glensimister/rombi/README.md

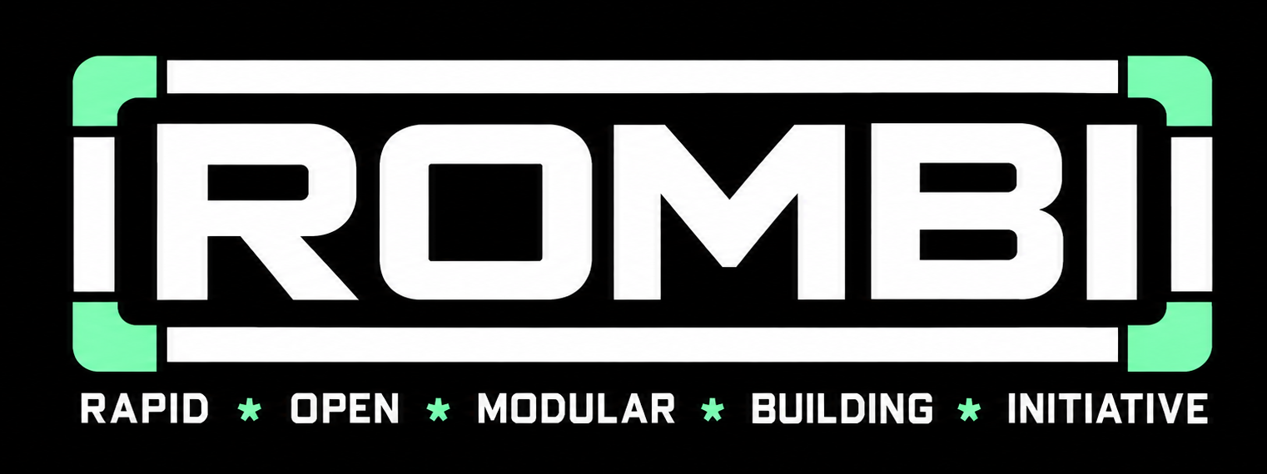
[picture p1: images/rombi_mint_wordmark.png]


<p>ROMBI consists of modular panels that can be made with practically no skills. There are some good modular framing systems out there, such as V-slot and T-slot, but they are typically meant for engineers. They are too heavy, too expensive, and relatively inaccessible to the average person. I came up with this system to make modular construction fast, affordable and accessible.</p>

<p>A lot of time and money has already gone into this project, and I plan to keep improving it. Please support me by making a donation:</p>
<a href="https://www.paypal.com/donate/?hosted_button_id=NUNFJG6USY3QL" target="_blank">
  
</a>

## Documentation

- [Assembly Guide](docs/assembly-guide.md)
- [Materials and Tools](docs/materials-and-tools.md)
- [Design Principles](docs/design-principles.md)
- [Use Cases](docs/use-cases.md)

Please also check out: - [Why ROMBI Could Be a Good Fit for Liberland](docs/rombi-and-liberland.md)  

## NOTE: Below are photos of the prototype. The core design has since changed, although still roughly the same. There maybe also be some inconsistencies, such as mismatching corner connectors, which will be addressed in due course. I will upload more photos as the project progresses.   

<center>
  <table>
      <tr>
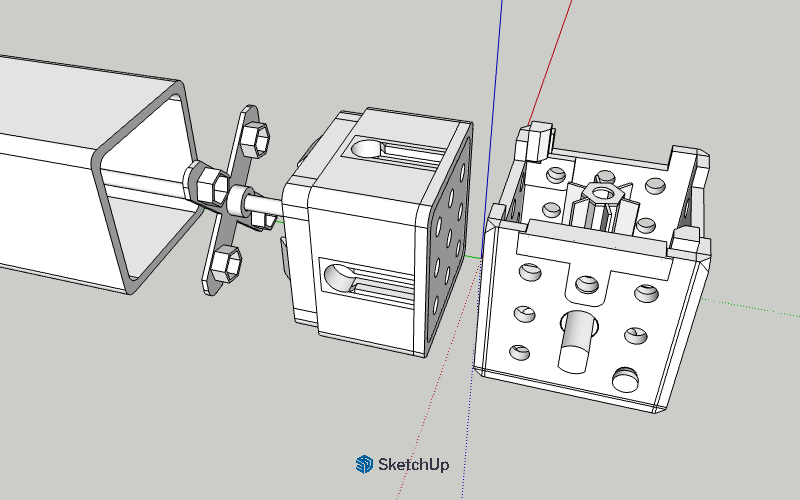
[picture p2: images/V1/3D-models-partially-constructed.png]
              <td></td>
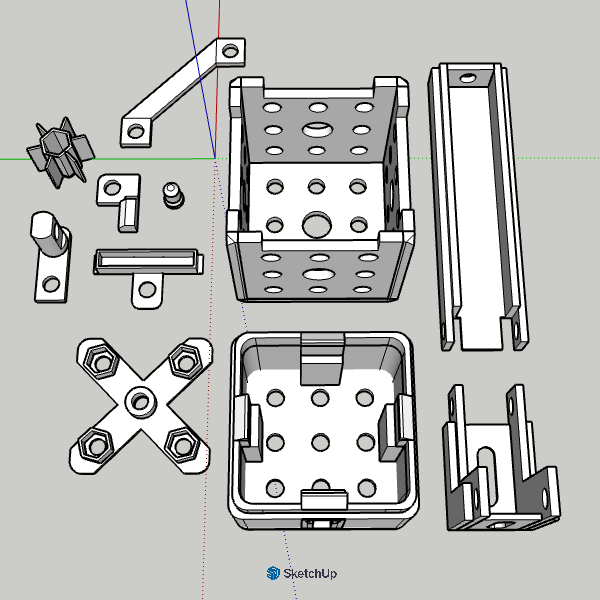
[picture p3: images/V1/3D-models-collection.png]
              <td></td>
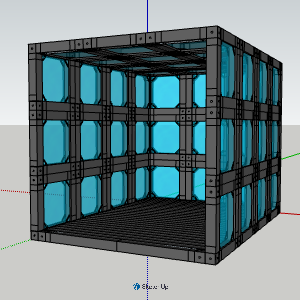
[picture p4: images/van-conversion-interia.png]
              <td></td>
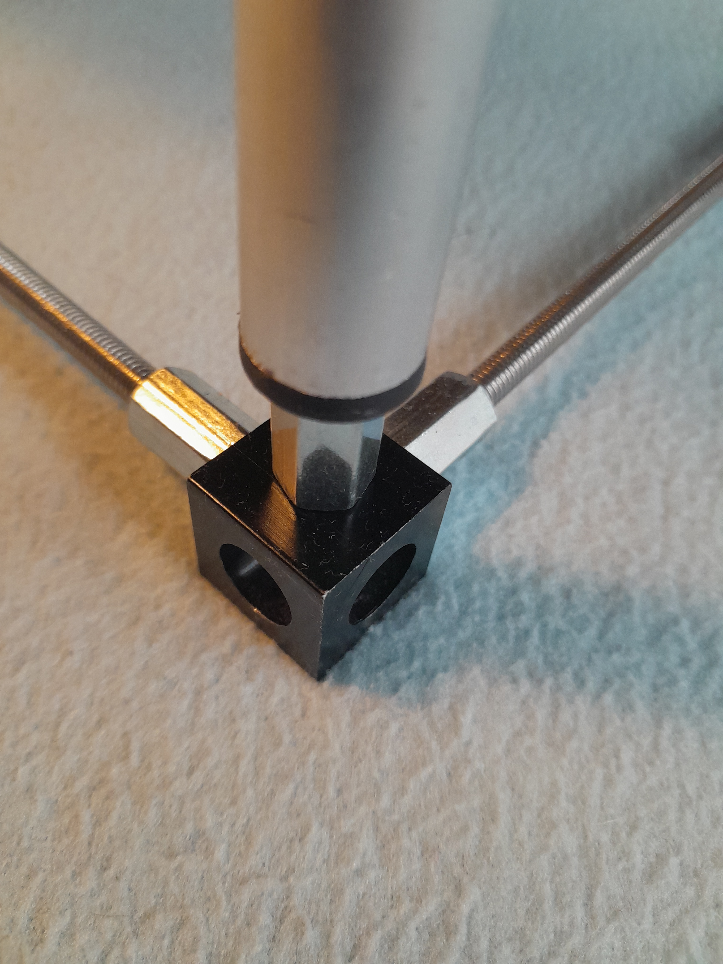
[picture p5: images/photos/20261106_133503.jpg]
              <td></td>
        </tr>
    <tr>
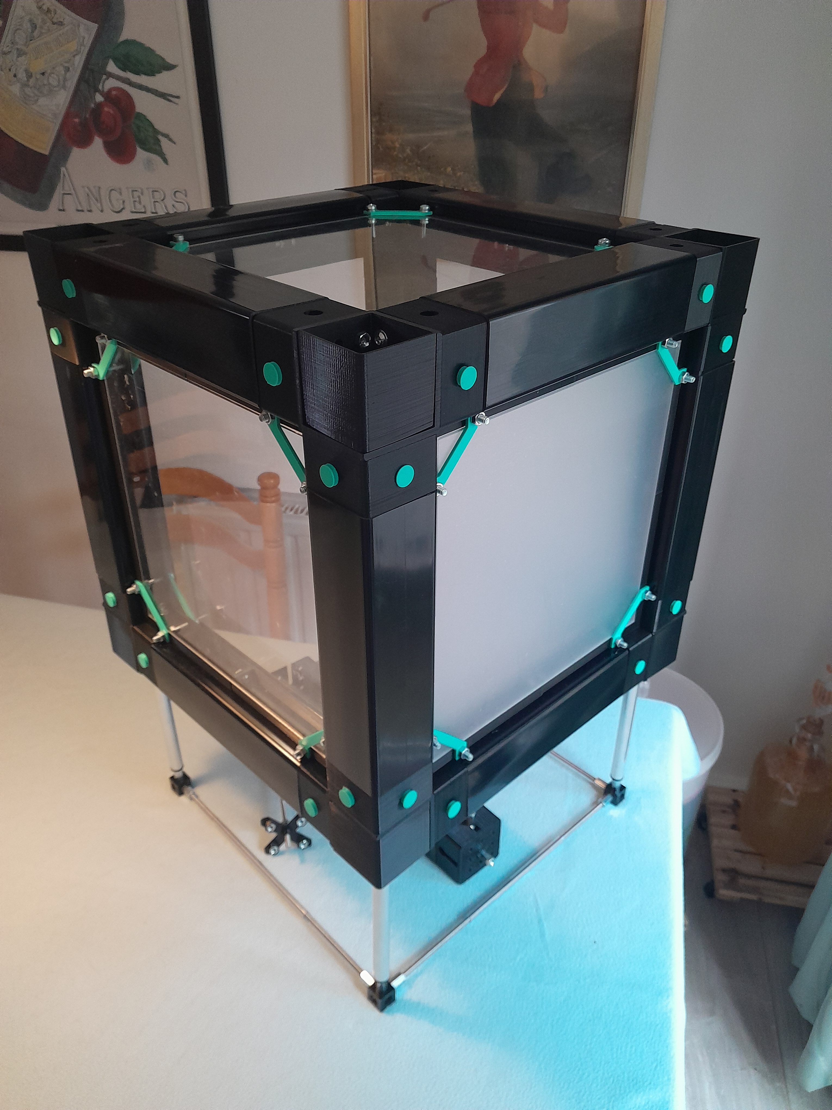
[picture p6: images/photos/20261106_133025.jpg]
      <td></td>
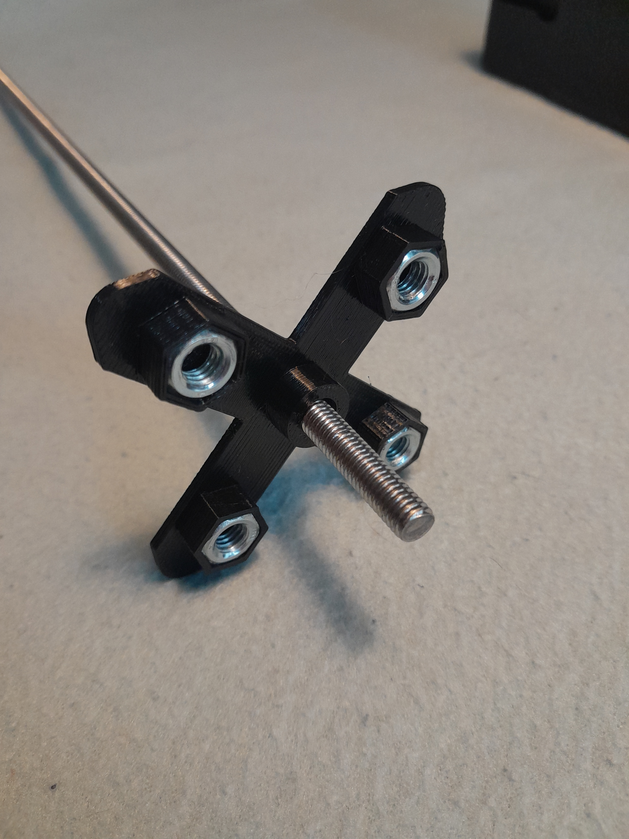
[picture p7: images/photos/20261106_133137.jpg]
      <td></td>
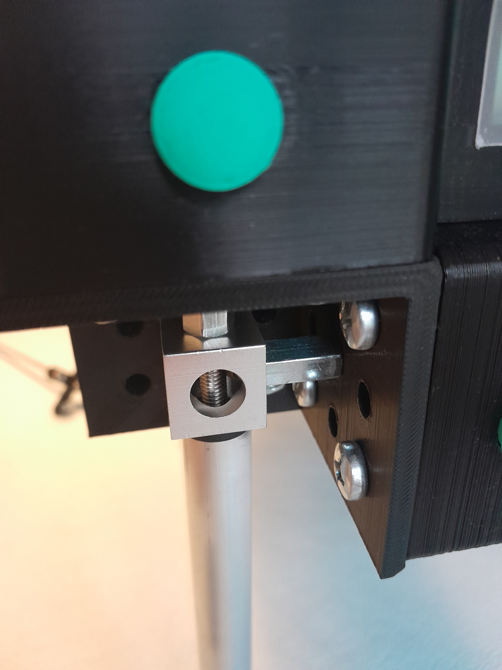
[picture p8: images/photos/20261106_134456.jpg]
      <td></td>
      <td></td>
    </tr>
        <tr>
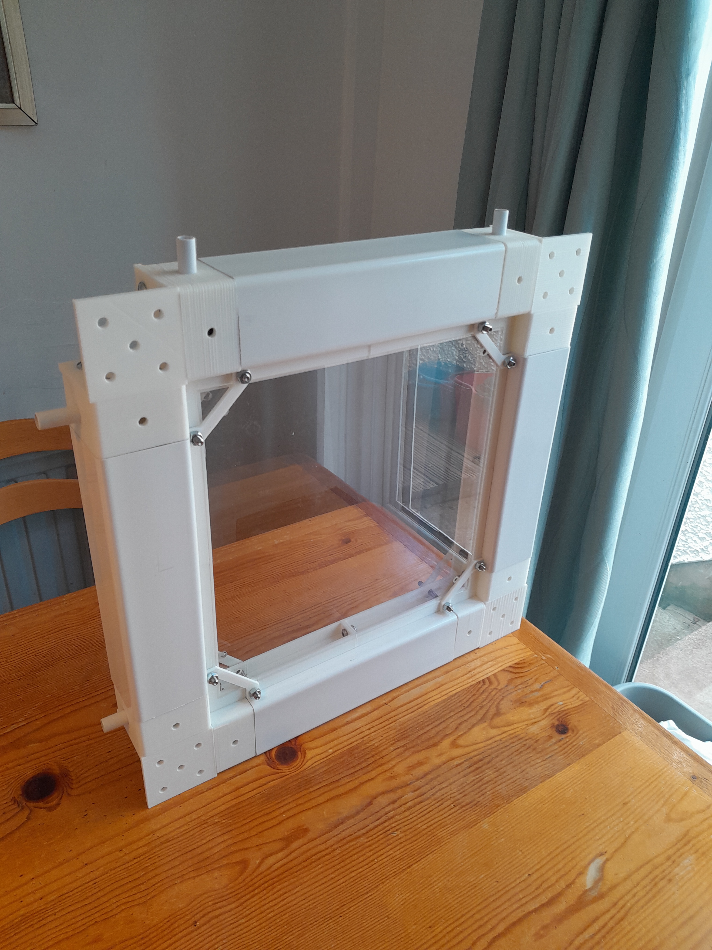
[picture p10: images/Single-panel-white.jpg]
              <td></td>
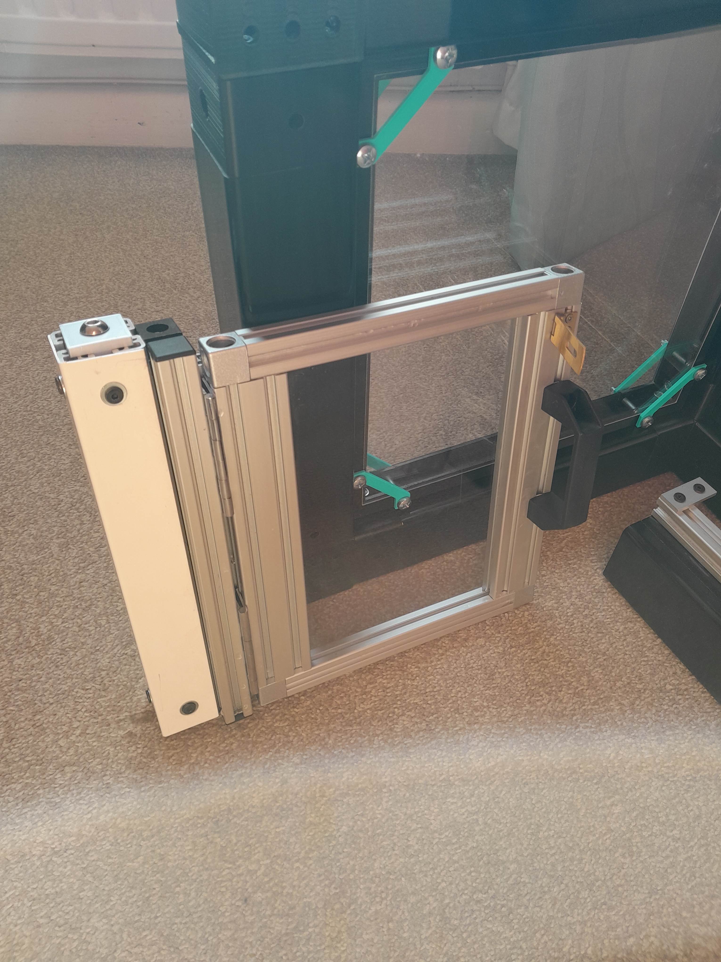
[picture p11: images/V-Slot-Door.jpg]
              <td></td>
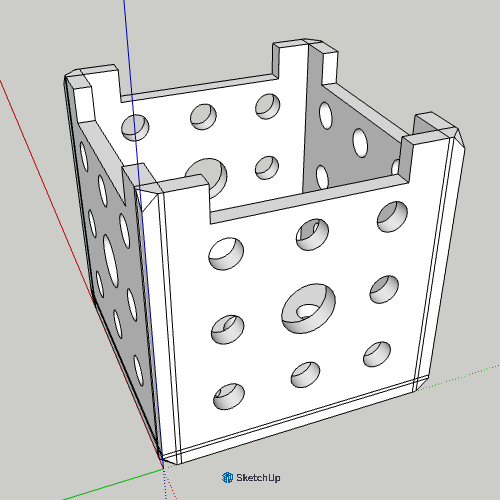
[picture p12: images/V1/5-way-connector-with-spanner-slot-V1.png]
              <td></td>
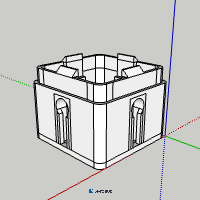
[picture p13: images/V1/keyhole-spindle-V1.png]
              <td></td>
        </tr>
  </table>
</center>

<p>ROMBI is made from a combination of standard British FloPlast square drain pipe, 3D printed corner connectors, and off-the-shelf perspex sheets. As such, it is very affordable. The square pipe is currently available in black, white and brown, while the 3D printed connectors can be any colour. </p>
<p>Different countries have different standards. The repository can be cloned and adapted accordingly. However, I don't plan to cater for different standards quite yet.</p>  

 <p>ROMBI can be used for Room Partitions, Sensory Deprivation Enclosures, Cinema, Gaming & VR Booths, Children's Mini-Cinemas & Hideaways, Personal Focus & Video-Call Booths, Vocal, Voiceover & Podcast Booths, Mobile DJ & Karaoke Booths, Photo & Content-Creation Booths, Pet Shelters & Animal Enclosures, Livestock & Veterinary Recovery Enclosures, Kiosks & Exhibition Booths, 3D Printer & Equipment Enclosures, Generator Enclosures Server & Network Enclosures, Food Fermentation & Proofing Chambers, Hydroponic & Growing Chambers, Battery Energy Storage, Enclosures Emergency & Earthquake Shelters, and more. </p>

<p>ROMBI is currently version 1, marked as V1. It will stay on V1 until a core change has been made (affecting the majority of components). At which point a new folder will be created (V2), with V1 kept as legacy. Ideally, there won't be many (if any) changes to the core.</p>
<p>The size of a single panel is 455mm x 455mm x 65mm. All sizes are multiples of 65mm, the size of the PVC square pipe. E.g. 65 x 7 = 455. This allows you to use the square pipe for floor and roof panels.</p>

<h2>Windows & Doors</h2><p>The design doesn’t include openable windows and doors yet. I plan to use V-slot (see the adjecent image) for the doors due to the advanced sliding/railing systems. I want the doors to be more futuristic/advanced, as opposed to the typical style.</p>
