glensimister/rombi/docs/design-principles.md

[← Back to ROMBI home](../README.md)

## Principles of Modular Design, and how ROMBI Addresses Them
<p>
Before discussing the principles of modular design, and how ROMBI Addresses them, let's start by reviewing the limitations of modular building systems.

Security: Naturally, the more secure a structure is, the less modular it will be. If it’s easy to build and maintain, it will be easy to steal and sabotage. However, that doesn’t mean it is impossible to apply security techniques to prevent unauthorized access, it just means it should be an after-thought. For example, the window panels are very easy to replace. However, to get around this, you could use one-way bolts, with the nut on the inside of the structure. Even still, this shouldn’t be a part of the ROMBI core. After all, you might live in a gated community, or decide to put the structure inside another, more secure structure. I (and hopefully others) will provide security add-ons, and you can choose which is the most suitable.  

Waterproofing: The use of sealant would make the structure less modular. It might be tempting, but it should be used as a last resort. As above, add-ons will be available, but waterproofing will not be a part of the ROMBI core. Perhaps you might want to consider putting the structure inside a large greenhouse or geodesic dome. Some do this in Scandinavia, and there are many benefits of doing so. Alternatively, you might want to put it under a gazebo, or inside a warehouse, shipping container or van.  

Open-Plan: Open-plan spaces typically require large support beams. However, it’s worth bearing in mind that the maximum length of square downpipe in the UK is 5.5 meters. As such you can build an open-plan space that size. The pipe won’t provide much structural strength, but it’s fine for a single-story structure with an outer shell. 

Windows & Doors: Since we don’t know what we are building, it’s quite hard to design a universal system for windows and doors. I suggest using v-slot for this purpose. I have already built a small test door using v-slot, and I will upload the specs at a later stage.  
</p>

| Principle | Description | How ROMBI addresses it |
|---|---|---|
| **Accessibility** | Materials and components should be inexpensive and readily available. | ROMBI uses standard PVC square downpipe, M6 threaded rods, off-the-shelf Perspex sheets and 3D-printed connectors. Users are encouraged to substitute locally available materials to suit their region. |
| **Flexibility and Reusability** | Components should be reusable and adaptable to different applications without requiring a complete rebuild. | The modular connectors and panels allow structures to be assembled, disassembled, reconfigured and repurposed. |
| **Precision and Consistency** | Components should have consistent dimensions and interfaces, allowing them to fit together reliably. | ROMBI uses defined component dimensions and standardised connection points. Future revisions will aim to improve tolerances and interchangeability. |
| **Lightweight Construction** | Components should be lightweight enough to handle and assemble without heavy equipment. | The system uses lightweight PVC framing, thin sheet materials and 3D-printed connectors, reinforced with threaded steel rods where required. |
| **Simple Assembly and Maintenance** | Structures should be quick to assemble, disassemble and maintain, ideally without power tools. | The system is designed around modular connections and commonly available hardware, minimising the need for specialist tools or permanent fixings. |
| **Structural Integrity** | Connections and structural members should work together to provide adequate strength and stability for their intended application. | ROMBI incorporates steel threaded rods and aluminium V-slot corner cubes into its reinforced frame design. Structural performance must be validated for each intended application. |
| **Version Control** | Design changes should be documented so that components and assemblies can be identified, reproduced and improved. | ROMBI uses numbered design series, beginning with Series 1. Design files and documentation are maintained in a version-controlled repository. |
| **Flat-Packability and Portability** | Components should be easy to transport and store, with minimal wasted space. | The system can be disassembled into individual components and flat-packed. In principle, a building can be dismantled, transported and reassembled at a new location. |
| **Environmental Responsibility** | Materials and construction methods should minimise waste and environmental impact throughout the product lifecycle. | Reusability, lightweight transportation, repairability and the avoidance of concrete and timber in the primary frame are design considerations. Material durability, recyclability and whole-life impacts remain important considerations. |
| **Customisation** | Users should be able to adapt the appearance and configuration to their own preferences. | Frame colours can be selected to suit available materials, while 3D-printed connectors and accessories can be produced in different colours. Panels, dimensions and layouts can be adapted to individual projects. |
| **Cross-Compatibility** | A modular system should integrate with established products, components and standards wherever practical. | ROMBI is intended to accommodate compatible third-party systems, including V-slot aluminium extrusion for doors, openable windows and other accessories. |
| **Integrated Cable Management** | Electrical cables and other services should be accommodated without unnecessarily obstructing the structure or requiring extensive modifications. | Holes in the corner connectors allow cables to pass internally or externally. Unused openings can be closed with removable plugs. |
| **Scalability** | The same underlying principles should apply to projects of different sizes, from small enclosures to larger structures. | ROMBI is being developed as a common modular platform for a range of applications, with the long-term aim of scaling from small prototypes towards larger buildings. |
| **Repairability and Replaceability** | Individual parts should be replaceable without requiring the entire structure to be dismantled or discarded. | Modular construction allows damaged or outdated components to be replaced individually, subject to accessibility of the relevant connections. |
| **Open Design and Collaboration** | Design files and documentation should be available so that others can inspect, reproduce, modify and improve the system. | ROMBI is intended to be an openly documented project. Users are encouraged to fork the repository, adapt the designs to locally available materials and contribute improvements. |
| **Documentation and Reproducibility** | A design should be documented well enough for others to understand, reproduce and maintain it without relying on the original designer. | The project will include CAD and manufacturing files, assembly instructions, material specifications, photographs and records of design revisions. |
| **Adaptability to Local Materials** | A modular system should not depend on the availability of one particular material or product in every country. | Although the initial design uses UK-standard 65 mm square downpipe, the open design allows users to develop alternative connectors and structural dimensions for materials available in their own regions. |
| **Minimal Specialist Equipment** | Construction should be achievable by individuals and small groups without access to industrial machinery. | The system relies on accessible materials, 3D-printed components and common hardware, with the aim of keeping fabrication and assembly requirements manageable. |
| **Incremental Development** | A system should be useful at small scales before requiring users to commit to a large or expensive project. | ROMBI can be developed and tested through small applications before being extended to more complex assemblies and larger structures. |
| **Long-Term Adaptability** | Structures should be capable of evolving as requirements change, rather than becoming obsolete when a single component or use case changes. | Replaceable modules, standardised interfaces and documented revisions are intended to allow existing structures to be modified as new components and applications are developed. |
