glensimister/rombi/images/V1/hex-nut-holder-V1.png

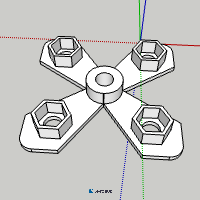
images/V1/hex-nut-holder-V1.png
