glensimister/rombi/docs/components.md

[← Back to ROMBI home](../README.md)

# Components & Files

Below are the STL files for the main panel. Please note that I made them using Sketchup Online, and was thus only able to export as STL format. At some point I will try to provide other formats.  

| Image | Description | Link to file | Version
|:---:|---|:---:|:---:|
|  | **5-Way Corner Connector** | [STL](../STL/V1/5-way-connector-with-spanner-slot-V1.stl) | 1 | 
|  | **Keyslot Spindle** | [STL](../STL/V1/keyslot-spindle-V1.stl)  | 1 | 
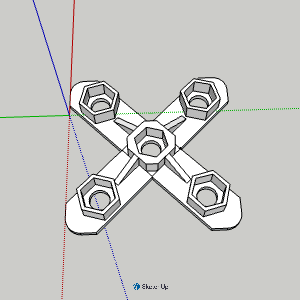
[picture p20: images/V1/strut-fastener-V1.png]
|  | **Strut Fastener** | [STL](../STL/V1/strut-fastener-V1.stl)  | 1 | 
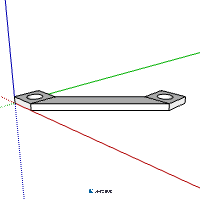
[picture p21: images/V1/panel-clip-V1.png]
|  | **Panel Clip** | [STL](../STL/V1/panel-clip-V1.stl)  | 1 | 
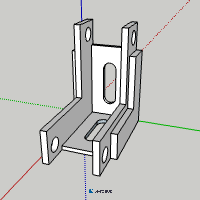
[picture p22: images/V1/panel-holder-corner-slotted.png]
|  | **Panel Holder Corner** | [STL](../STL/V1/panel-holder-corner-slotted-V1.stl)  | 1 | 
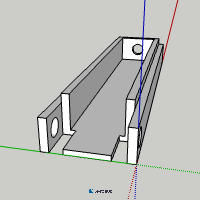
[picture p23: images/V1/panel-holder-long.png]
|  | **Panel Holder Long** | [STL](../STL/V1/panel-holder-long-V1.stl)  | 1 |
