glensimister/rombi/docs/materials-and-tools.md

[← Back to ROMBI home](../README.md)

## Equipment, Materials and Indicative Cost per L Panel

Modular construction systems can involve a higher initial material cost than conventional building methods because they require standardised components, specialised connectors and carefully designed interfaces. However, these upfront costs can potentially be offset by faster assembly, reduced labour, easier maintenance, and the ability to dismantle, reuse and reconfigure components.

As ROMBI develops, costs should decrease through design improvements, bulk purchasing, alternative suppliers and more efficient manufacturing methods. For further information, see **[Principles of Modular Design and How ROMBI Addresses Them](../docs/design-principles.md)**.

The following figures are **rough estimates based on current prototype materials and example retail prices**, not a fixed bill of materials or a final quotation. Actual costs will vary according to supplier, location, availability, quantity purchased, manufacturing method and future design revisions.

Readers are encouraged to source materials locally, manufacture components themselves where practical, or use third-party services. Optional equipment and accessories are listed separately and are excluded from the core estimate.

### 1. Equipment (Optional)

You do not need to own all the equipment listed below. For example, 3D-printed components can be ordered from a commercial printing service using the published design files.

| Equipment | Approximate Cost | Notes |
|---|---:|---|
| Creality Ender 3 KE 3D printer | £200 | Example printer. Any suitable printer or third-party printing service may be used. |
| PETG filament and filament dryer | Varies | Approximately 1 kg of PETG filament is required for the current L-panel design. Filament costs approximately £12 per kg. A dryer may be useful depending on storage conditions and print quality requirements. |
| Stanley clamping mitre box and saw | £60 | For cutting PVC pipe and other components to length. |
| 6 mm T-handle Allen key or equivalent | £5 | Some connectors require a tool with approximately 65 mm of reach. A suitable Allen key or hex driver may be sufficient. |

*Equipment costs are illustrative purchase prices, not mandatory expenses. The 3D printer is optional if parts are outsourced, and tools may already be available to the builder.*

### 2. Core Materials and Components

The following table describes the main materials used in the current L-panel prototype. Prices are approximate and may change as the design evolves.

| Image | Material / Component | Specification and Use | Approximate Cost |
|:---:|---|---|---:|
|  | **PVC square downpipe** | FloPlast 65 × 65 mm square downpipe, approximately 1.95 mm wall thickness, cut into 245 mm sections. Six sections are required per L panel. Example product standard: BS EN 12200-1:2004. Available in white, brown and black. | £3.70/m; approximately £5.50 per panel |
|  | **Clear acrylic sheets** | Four 300 × 300 mm sheets, 3 mm thick, form the double-glazed panels. The example price reflects a discounted purchase and is not a guaranteed retail price. | Approximately £12 for four sheets |
|  | **PETG filament** | Approximately 1 kg for the 3D-printed components in the current L-panel design. | Approximately £12 |
|  | **M6 × 16 mm button-head screws with flange** | ISO 7380-2:2011. Used to connect corner connectors to the spindles. Forty screws are required. | £6 per 20; approximately £12 for 40 (to be amended) |
|  | **M6 × 20 mm round coupling nuts** | Used between the panel-holder brackets. Sixteen are required. | Approximately £7 per 20; £5.60 for 16 |
|  | **M6 350mm threaded rods** | Fully threaded rods, approximately 350 mm long, used to reinforce the frame. Cutting rods to length from bulk stock may be cheaper but could require additional tools. | Approximately £17 per four-piece kit |
|  | **20 × 20 mm aluminium V-slot corner cubes** | Structural corner connectors used with the steel reinforcement rods. Six are required per L panel. | Approximately £15 per pack of 8; £11.25 allocated to six |
|  | **M6 hex stud connectors** | Approximately 18 mm long. Used as part of the connector assembly. Available from general hardware retailers. | Approximately £8 per pack of 30 ||
|  | **Standard M6 hex nuts** | DIN 934 / ISO 4032; 10 mm width across flats and approximately 5 mm high. Used where required by the threaded connections. | Approximately £5 per pack of 50 |

*Costs are indicative estimates. Pack prices, actual quantities used, supplier discounts and future design changes will affect the final cost.*

### 4. Optional Extras

These components are not required for every application and are excluded from the core material estimate.

| Optional Component | Description | Approximate Cost |
|---|---|---:|
| **PVC spacer tubes** | White PVC tube, approximately 12 mm outside diameter and 10 mm inside diameter, cut into 40 mm sections. Used for positioning panels and creating the stacking arrangement. Longer sections may also be used where needed. | £3.50 per metre |
| **M6 female-threaded gas spring strut end fittings** | Flexible threaded fittings that may provide additional reinforcement or alternative connection arrangements. Their suitability depends on the final structural design. | Approximately £10 per pack of 6 |
| **M6 serrated flanged nuts** | Used on panel-corner connectors where resistance to loosening is desirable. Sixteen are required in the current arrangement. | Approximately £2.95 per pack of 10 |
| **Foam pipe insulation** | Approximately 1.8 m of foam insulation, with an internal diameter of 43 mm and external diameter of 61 mm. Intended for placement inside the square PVC frame to improve insulation. | Approximately £12 |

### 5. Preliminary Cost Estimate

### IMPORTANT: The calculations below are based on the highest estimates. Naturally, buying in bulk (or ordering from China) will bring the costs down. This may not be an option at first, but could be an option at a later stage. For example, the v-slot corner cubes are much cheaper when buying from China. Additionally, the threaded rod is quite expensive when buying pre-cut sections. Cutting the rod yourself will bring the cost down a lot, but cutting metal is beyond the scope of this project.  

Based on the current design, the following is a provisional guide rather than a definitive price.

| Cost Category | Approximate Cost (rounded) |
|---|---:|
| PVC downpipe | £5 |
| Acrylic sheets | £12.00 |
| PETG filament | £12.00 |
| M6 × 16 mm button-head screws | £20 |
| M6 coupling nuts | £6 |
| Four-piece threaded-rod kit | £12.00 |
| Six aluminium V-slot corner cubes | £11 |
| **Subtotal of priced core items** | **£80** |

This subtotal includes the estimated cost of the specified quantities of priced components, including the PETG filament, but excludes the additional hardware whose quantities or costs have not been fully established. It also excludes optional extras, equipment, labour, outsourced 3D printing, delivery charges and any waste or spare materials.

The actual amount spent purchasing materials may be higher because some components are sold only in packs. Conversely, bulk purchasing, alternative suppliers, discounted materials and in-house manufacturing may reduce the effective cost.

**This is an early-stage estimate for the current prototype, not a final production cost.** A more accurate figure will be published when the design, bill of materials and manufacturing process are sufficiently stable.
