glensimister/rombi/STL/V1/strut-fastener-V1.stl

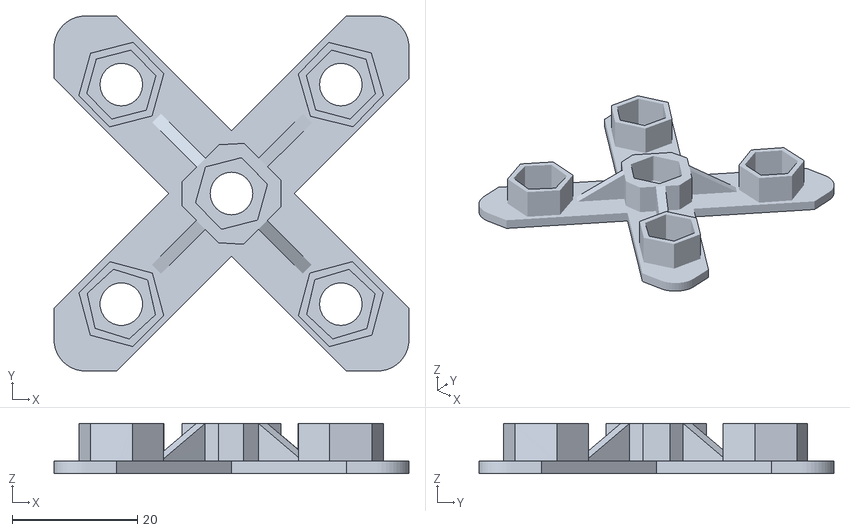
[picture p24: CAD file, 2026-11-12]
STL/V1/strut-fastener-V1.stl
56.6 x 56.6 x 8.00
