glensimister/rombi/STL/V1/16.5mm-measuring-tool-V1.stl

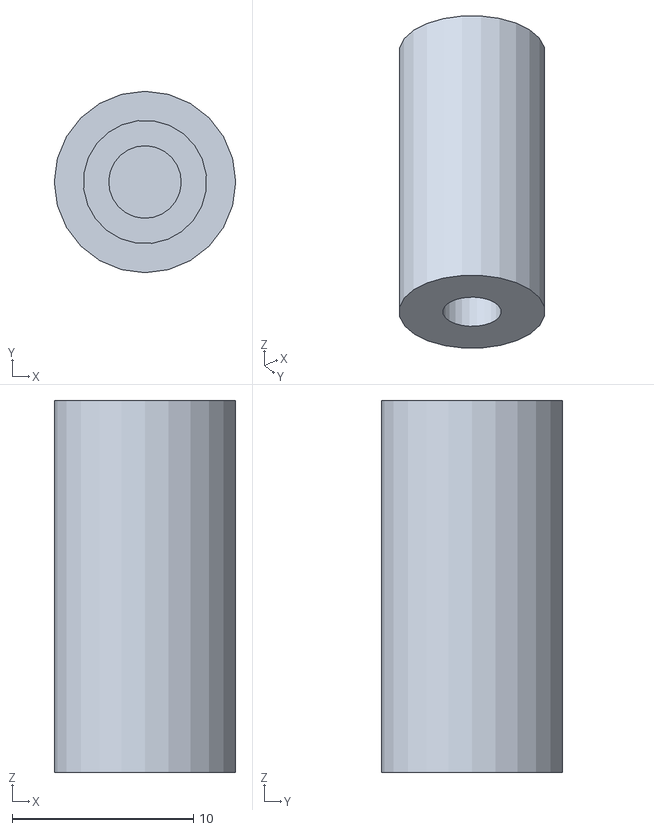
[picture p25: CAD file, 2026-11-12]
STL/V1/16.5mm-measuring-tool-V1.stl
10.0 x 10.0 x 20.5
