glensimister/rombi/STL/V1/spanner-slot-cover-V1.stl

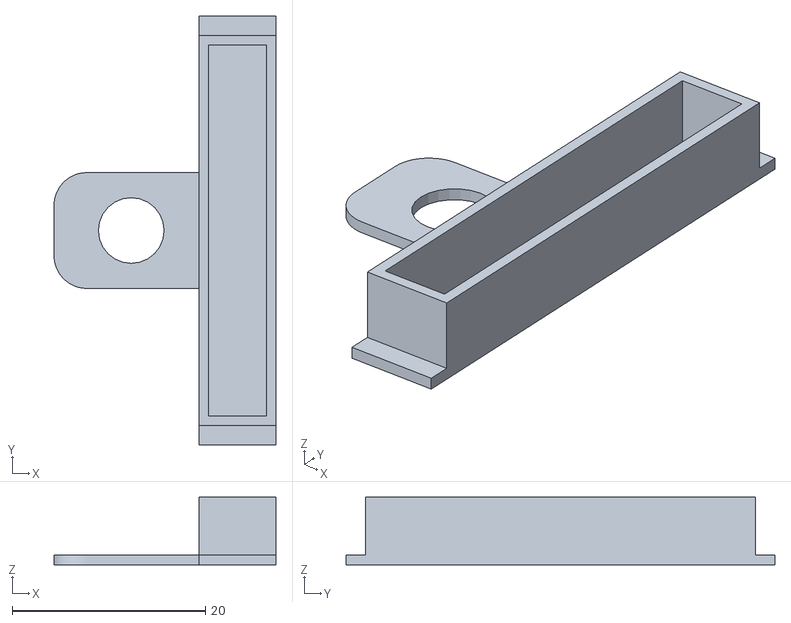
[picture p26: CAD file, 2026-11-10]
STL/V1/spanner-slot-cover-V1.stl
23.0 x 44.4 x 7.00
