glensimister/rombi/STL/V1/connector-widget-V1.stl

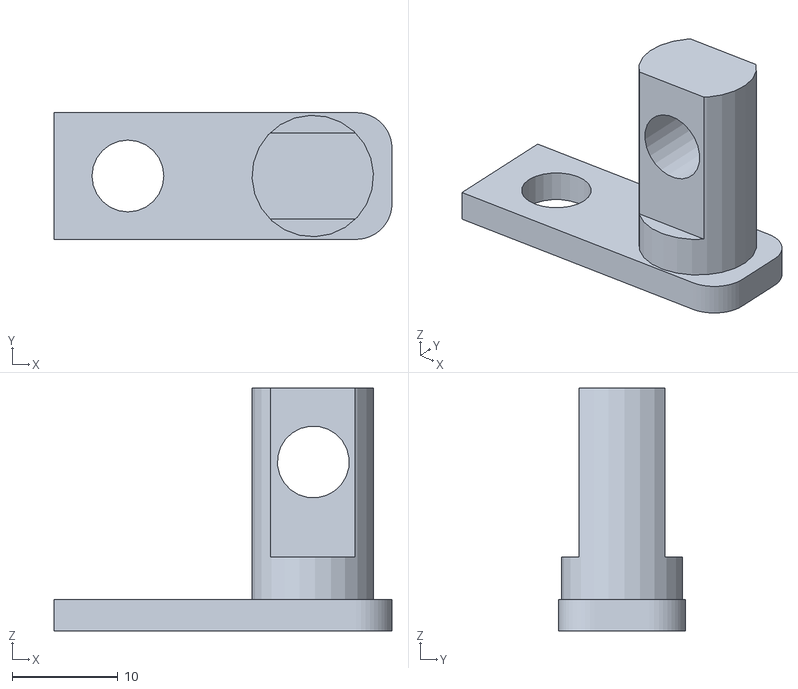
[picture p27: CAD file, 2026-11-08]
STL/V1/connector-widget-V1.stl
32.0 x 12.0 x 23.0
