glensimister/rombi/STL/V1/6mm-hole-plug-V1.stl

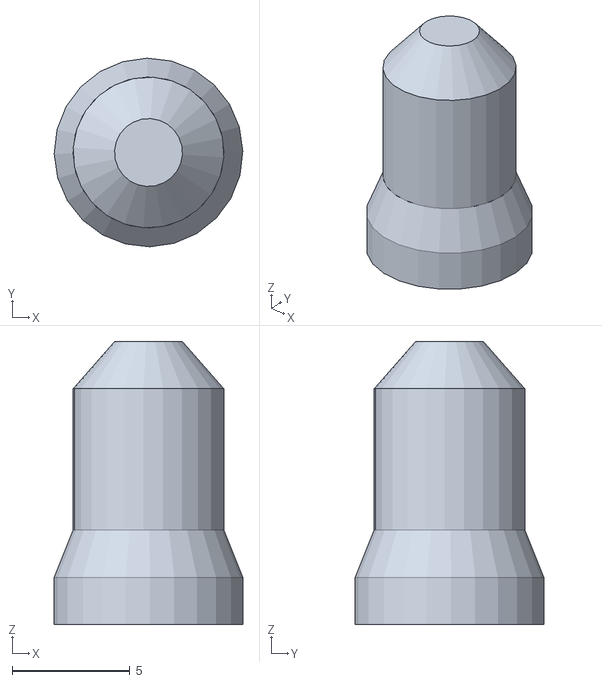
[picture p28: CAD file, 2026-11-08]
STL/V1/6mm-hole-plug-V1.stl
8.00 x 8.00 x 12.0
