glensimister/rombi/STL/V1/corner-guide-V1.stl

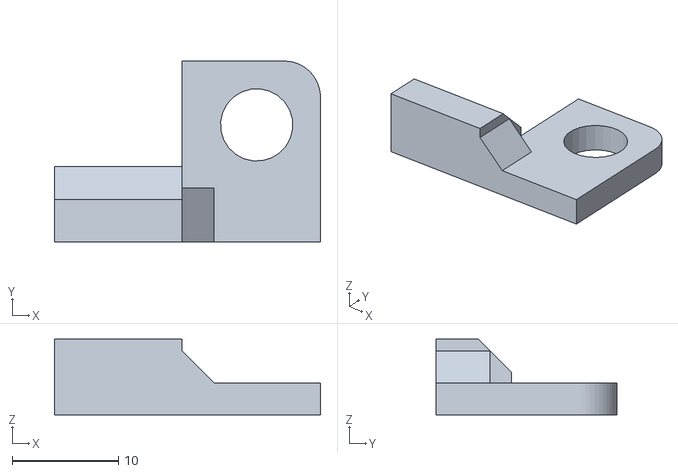
[picture p29: CAD file, 2026-11-08]
STL/V1/corner-guide-V1.stl
25.0 x 17.0 x 7.10
