glensimister/rombi/STL/V1/5-way-connector-with-spanner-slot-V1.stl

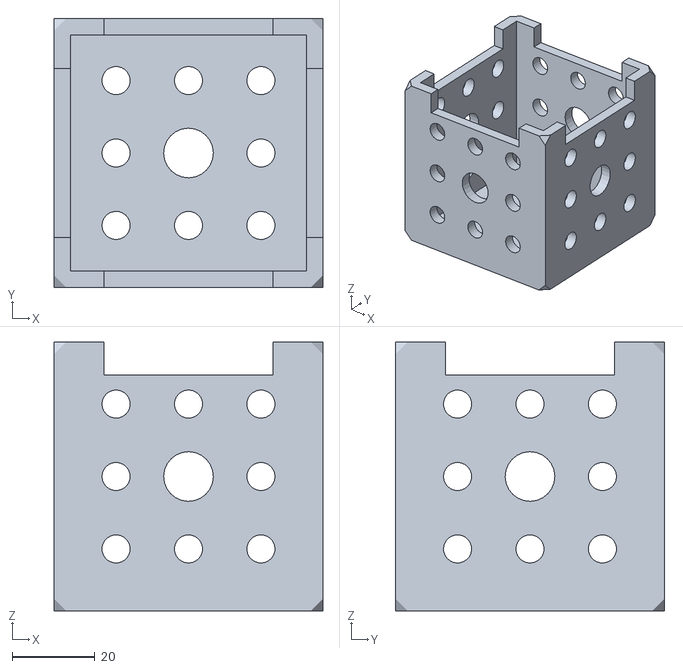
[picture p30: CAD file, 2026-11-07]
STL/V1/5-way-connector-with-spanner-slot-V1.stl
65.0 x 65.0 x 65.0
