glensimister/rombi/STL/V1/keyslot-spindle-V1.stl

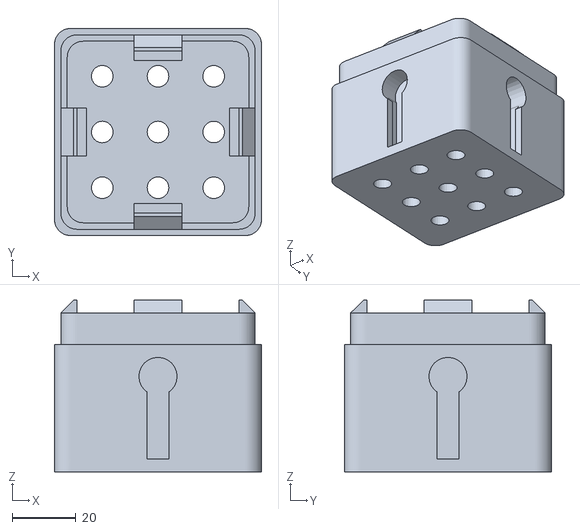
[picture p31: CAD file, 2026-11-04]
STL/V1/keyslot-spindle-V1.stl
65.0 x 65.0 x 54.0
