glensimister/rombi/STL/V1/panel-holder-long-V1.stl

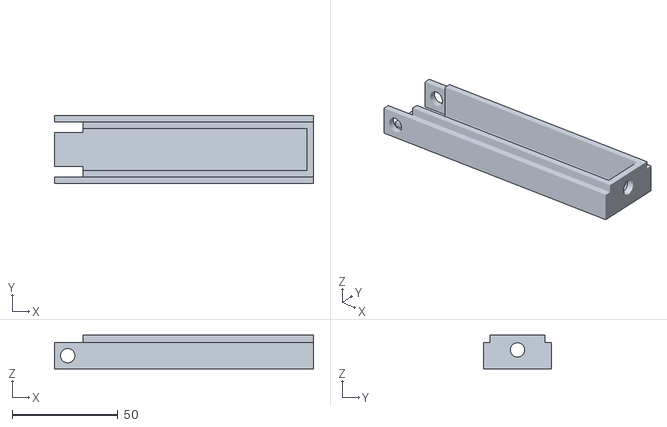
[picture p32: CAD file, 2026-11-04]
STL/V1/panel-holder-long-V1.stl
122.5 x 32.0 x 16.0
