glensimister/rombi/STL/V1/panel-holder-corner-slotted-V1.stl

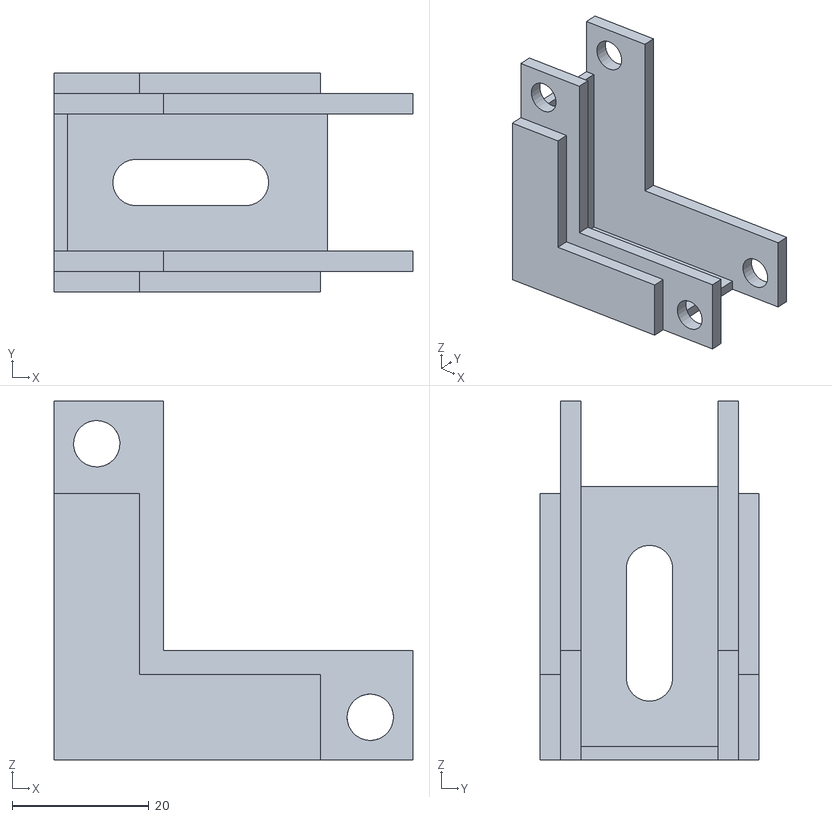
[picture p33: CAD file, 2026-11-03]
STL/V1/panel-holder-corner-slotted-V1.stl
52.5 x 32.0 x 52.5
