glensimister/rombi/STL/V1/panel-clip-V1.stl

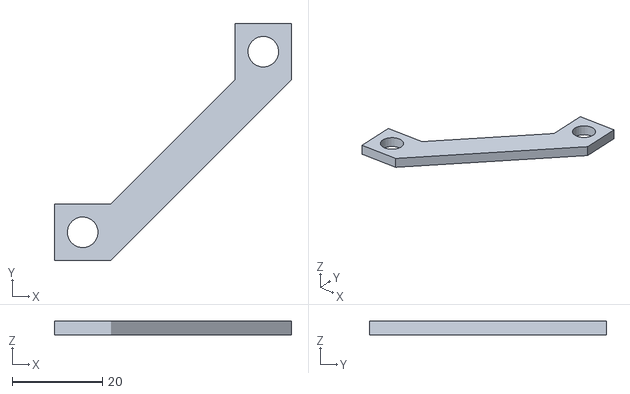
[picture p34: CAD file, 2026-10-31]
STL/V1/panel-clip-V1.stl
52.5 x 52.5 x 3.00
