glensimister/rombi/STL/V1/hex-nut-spacer-V1.stl

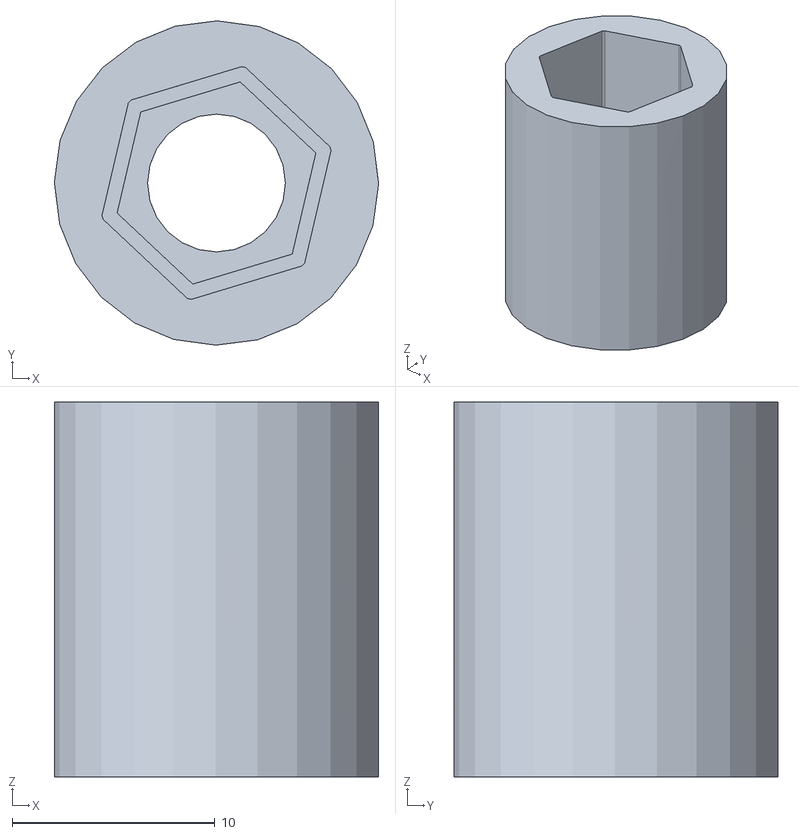
[picture p35: CAD file, 2026-11-12]
STL/V1/hex-nut-spacer-V1.stl
16.0 x 16.0 x 18.5
