glensimister/rombi/STL/V1/long-hex-nut-turner-V1.stl

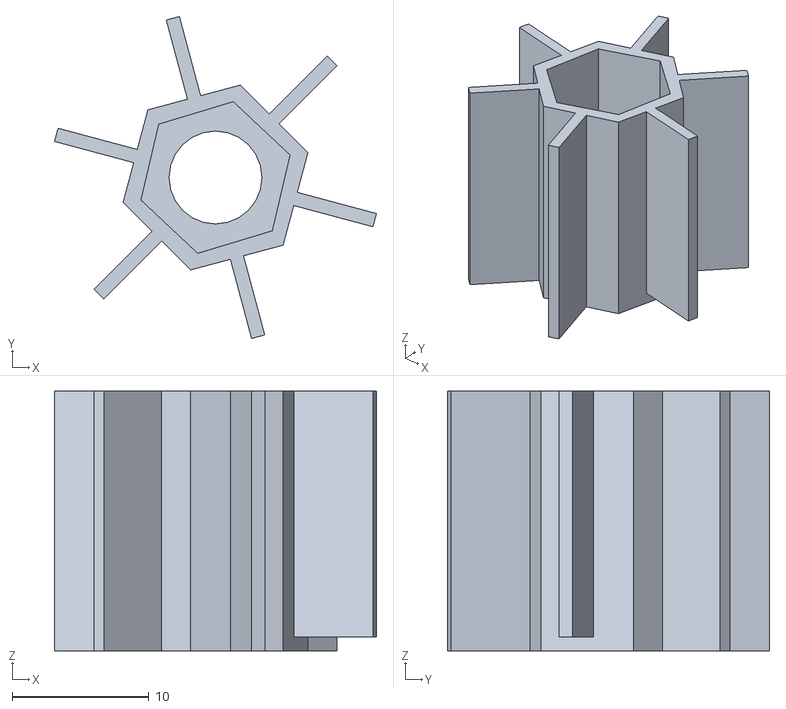
[picture p36: CAD file, 2026-11-07]
STL/V1/long-hex-nut-turner-V1.stl
23.6 x 23.6 x 19.0
