glensimister/rombi/STL/V1/hex-nut-holder-V1.stl

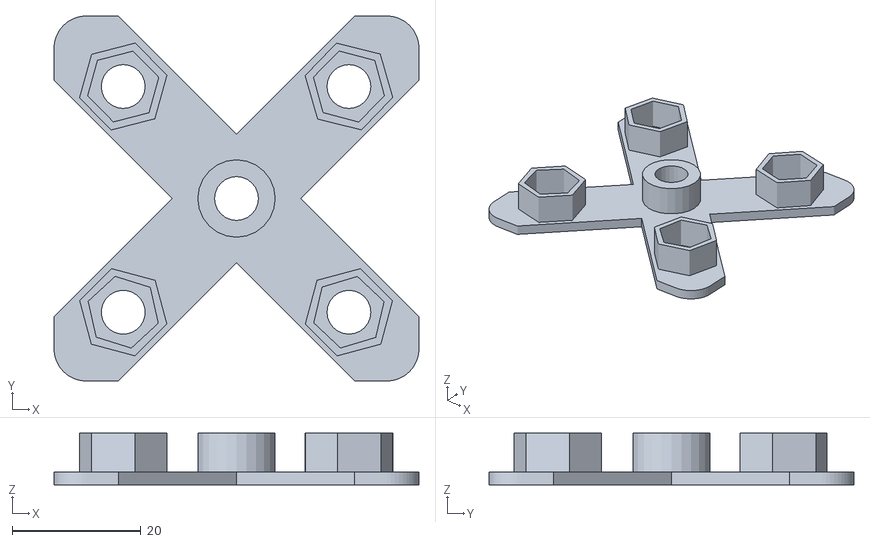
[picture p37: CAD file, 2026-11-06]
STL/V1/hex-nut-holder-V1.stl
56.6 x 56.6 x 8.00
