glensimister/rombi/docs/assembly-guide.md

[← Back to ROMBI home](../README.md)

## This section is currently in progress. I hope to include clear photos, PowerPoint presentations, and perhaps even videos. 

<p>You can browse and download the 3D models from the STL folder. Prints should use PETG, and not PLA, to ensure that they are durable and weatherproof. If you have any questions, feel free to post an issue above. Alternatively, the ROMBI Facebook page is also a good place to ask questions.</p>  

## STEP 1: Build a strut

| Image | Description
|---|:---|
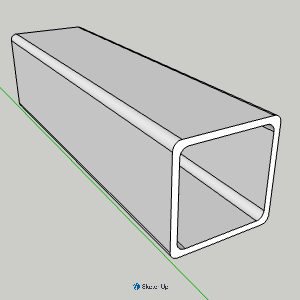
[picture p38: images/assembly/245mm-pipe.png]
 | Cut the square drain pipe into 245mm sections. I used a Stanley Mitre Box Saw. It's a non-electric saw with a guide to ensure a straight cut. Using an electric saw with PVC will create a lot of mess, and potentially break the pipe. | 
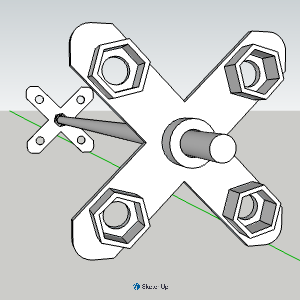
[picture p39: images/assembly/hex-nut-holder-on-both-ends.png]
 | Print 2 x [strut Fastener](../STL/V1/strut-fastener-V1.stl) objects. Take (2 x 5) standard UK hex nuts, and push them in to the hex slots. In the drawing there's 4 holes, but I have added one in the middle, which you can see in the STL. Thread the strut fasteners over the rod, leaving roughly 16.5mm thread on each end. I've created a [simple measuring tool](../STL/V1/16.5mm-measuring-tool-V1.stl) to help with this. Use nuts either side of the fastener to hold it in place. | 
 | Print 2 x [keyslot Spindle](../STL/V1/keyslot-spindle.stl) objects. For consistency, they should be the same color as the square pipe (black, white or brown). That said, it’s ultimately your choice.| 
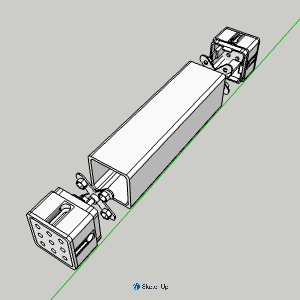
[picture p40: images/assembly/hex-nut-holder-inside-pipe.png]
 | Slide the two strut fasteners (including the rod) inside the pipe, and connect the keyslot spindles either side until the thread is visible on both ends. You should have roughly 12.5mm thread on each end.  | 
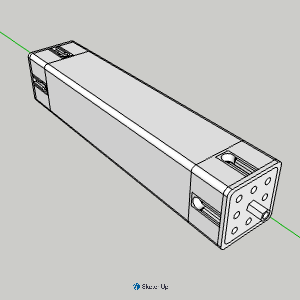
[picture p41: images/assembly/finished-strut.png]
 | Add a long hex nut (18mm) to each end. The strut is now finished. It's time to print the corner connectors. | 

## STEP 2: Build a corner

| Image | Description
|---|:---|
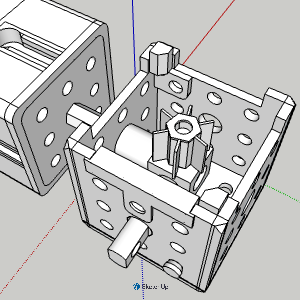
[picture p42: images/V1/corner-full-V1.png]
 | This is the corner with all mods attached. Print the following components and put it together.| 
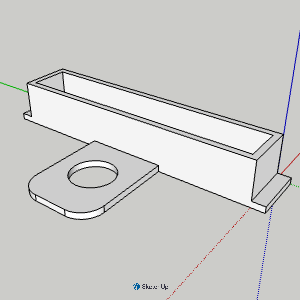
[picture p43: images/V1/spanner-slot-cover-V1.png]
 | Attach the [spanner slot cover](../STL/V1/spanner-slot-cover-V1.stl) - The purpose of the spanner slot is to allow enough room for a spanner to turn a vertical long hex nut. However, the long hex nut turner can be pushed over the hex nut to enable you to do it with your finger, or whatever. Both the spanner slot cover and the connector widget (below) are fastened via the same hole (top-middle).  | 
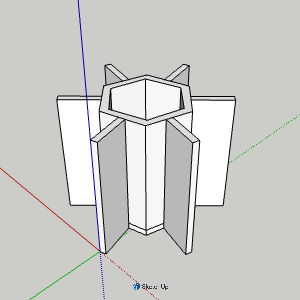
[picture p44: images/V1/long-hex-nut-turner-V1.png]
 | Print a [long hex nut turner](../STL/V1/long-hex-nut-turner-V1.stl) and use it to attach the panels vertically (see below). | 
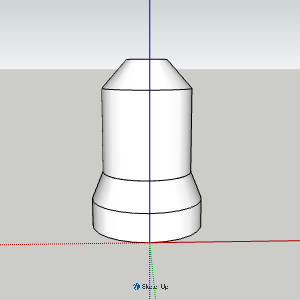
[picture p45: images/V1/6mm-hole-plug-V1.png]
 | Print some [hole plugs](../STL/V1/6mm-hole-plug-V1.stl) and push them in where you want to fill the holes. I will probably make these more discrete as they stick out too much. Also, I think it would be better to print them the same colour as the corner connector, to minimise visual clutter.  | 
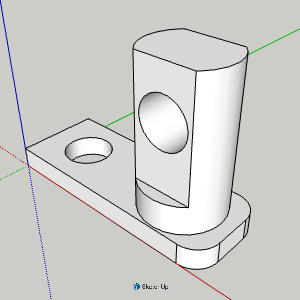
[picture p46: images/V1/connector-widget-V1.png]
 | Print 2 x [horizontal fastener](../STL/V1/connector-widget-V1.stl) objects. These are used for horizontal fastening on both sides of the connector, assuming it is a 2-way connector, and not a 3-way. You could also use an M6 gas strut head (eye bolt). They are stronger but can be a little bit expensive.| 
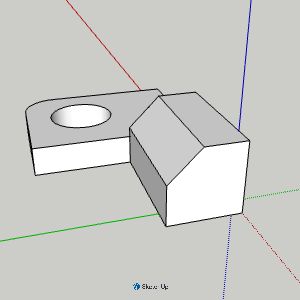
[picture p47: images/V1/corner-guide-V1.png]
 | 2 x [corner guide](../STL/V1/corner-guide-V1.stl) objects - The two corner guides should be fastened on opposite corners. The reason is because the ROMBI panels are stackable, and when they are stacked, the corner connectors have an inverse relationship with each other. So if you position the guides on the front left and back right, and then flip it upside-down, they will be front right, and back left.  | 
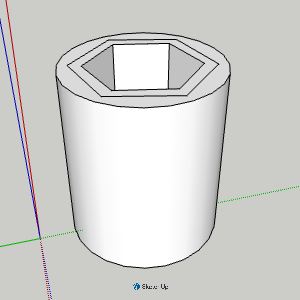
[picture p48: images/V1/hex-nut-spacer-V1.png]
 | Print 2/3 x [hex nut spacer](../STL/V1/hex-nut-spacer-V1.stl) objects. How many you print depends on whether it is a 3 way or 2 way corner. Once you have printed your components, slot the strut into the hole and push the hex nut spacer on the hex nut. It will probably be tight fit. The purpose of this spacer is to ensure that the aluminium corner cube is center aligned. Since all parts of the metal frame must be connected, you will need to purchase 20x20mm aluminium corner cubes, which are typically used for v-slot. When buying individually, they are not cheap, but the more you buy, and the longer you are willing to wait, the cheaper they are. NOTE: You won’t need to add the cube until all struts are connected. | 
 |  Attach the [5-Way Conector](../STL/V1/5-way-connector-with-spanner-slot-V1.stl) corner connector to the strut using M6 × 16 mm button-head bolts/screws with flange. It is recommended to use 1 in each corner. NOTE: Feel free to use whatever bolts you have available. | 

## STEP 3: Attach a panel

| Image | Description
|---|:---|
 | Place a standard M6 hex inside the keyslot. If you prefer, you can also put a standard UK hex bolt in there instead. | 
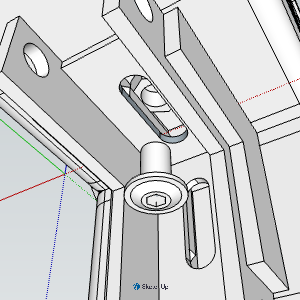
[picture p49: images/assembly/attach-corner-panel-bracket-to-keyslot-V1.png]
 | Attach the corner panel bracket to the keyslot. The keyslot is 8mm depth, and the bracket is 2mm. As such, a 10mm M6 bolt with a washer is probably the best option.  | 
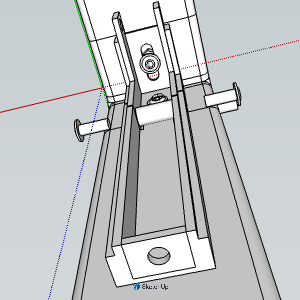
[picture p50: images/assembly/attach-long-panel-bracket.png]
 | Attach the long panel bracket to the corner panel bracket. Push an M6 coupling into the slot, and use 16mm M6 bolts either side to hold it together. NOTE: You can use one-way bolts if you want a structure which cannot be dismantled from the outside. You will still be able to loosen them from the inside. | 
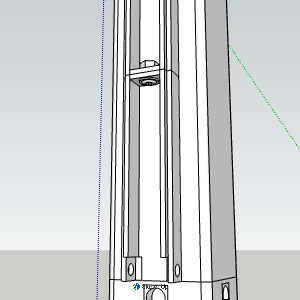
[picture p51: images/assembly/attach-long-panel-bracket-to-long-panel-bracket.png]
 | Attach another long panel bracket to one already there. Use 16mm M6 bolts either to hold them together. | 
 | Repeat all of the processes above until all struts, corners, and brackets are attached. Then, attach the perspex panel. It should rest in place, however, if it is stuborn, you will need to loosen the structure by loosening the long hex nuts on either side of the structs. Once both of the panels (front and back) are sitting nicely, tighten the structure, and add the panel clips to hold them in place. | 

## STEP 4: Stack a panel

This section is in progress. However, to summarize, you will need to repeat the steps above to complete an L-panel, or corner panel. Then stack them on top of each other. They should slot into place, as the corner connectors have guides. There's one important thing you will need to do in order to get them to fasten together vertically. The 5-way corner modules will contain aluminium corner cubes, which are there to hold the metal frame in place. The cubes are fastened to the frame via the long hex nut, on the end of the strut. They are fastened using 10mm M6 allen bolts. You will need to replace the downward facing bolt with a grub screw, that is approximately 35mm long. Then place a washer and hex nut no the screw to hold it in place. Then thread the long hex nut on the grub screw and place the hex nut turner object on the hex nut. This will enable you to spin it in order to attach the panels vertically. I will provide more detailed images in due course.  

| Image | Description
|---|:---|
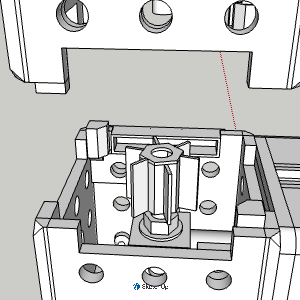
[picture p52: images/assembly/hex-turner.png]
 | Spin the hex turner to fasten the panels vertically. Notice how the guides slot into place to ensure the grub screws align.  | 
 | A different view of the vertical fastener. |
