glensimister/rombi/(commit log)

2026-10-22 Rename Door 1.jpg to V-Slot-Door.jpg
2026-10-31 Create STL-S1
2026-10-31 Create 3-Way-Connector
2026-10-31 Rename 5-Way Connector.stl to 5-way-connector-s1.stl
    [5-way-connector-s1.stl]
2026-10-31 Rename Hole Cover.stl to hole-cover-s1.stl
    [hole-cover-s1.stl]
2026-10-31 Rename Panel Fastener.stl to panel-fastener-s1.stl
    [panel-fastener-s1.stl]
2026-10-31 Rename Panel Holder Corner.stl to panel-holder-corner-s1.stl
    [panel-holder-corner-s1.stl]
2026-10-31 Rename Panel Holder.stl to panel-holder-long-s1.stl
    [panel-holder-long-s1.stl]
2026-10-31 Rename Rod Guide.stl to rod-guide-s1.stl
    [rod-guide-s1.stl]
2026-11-10 Create assembly
