glensimister/rombi/images/photos/20261108_153126.jpg

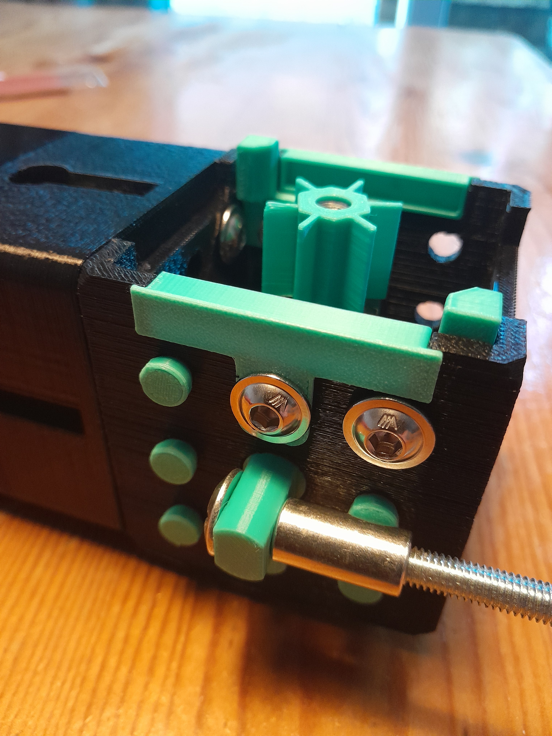
[picture p9: images/photos/20261108_153126.jpg]
images/photos/20261108_153126.jpg
